gwilken/ariadne-io/public/images/ari-wind.jpeg

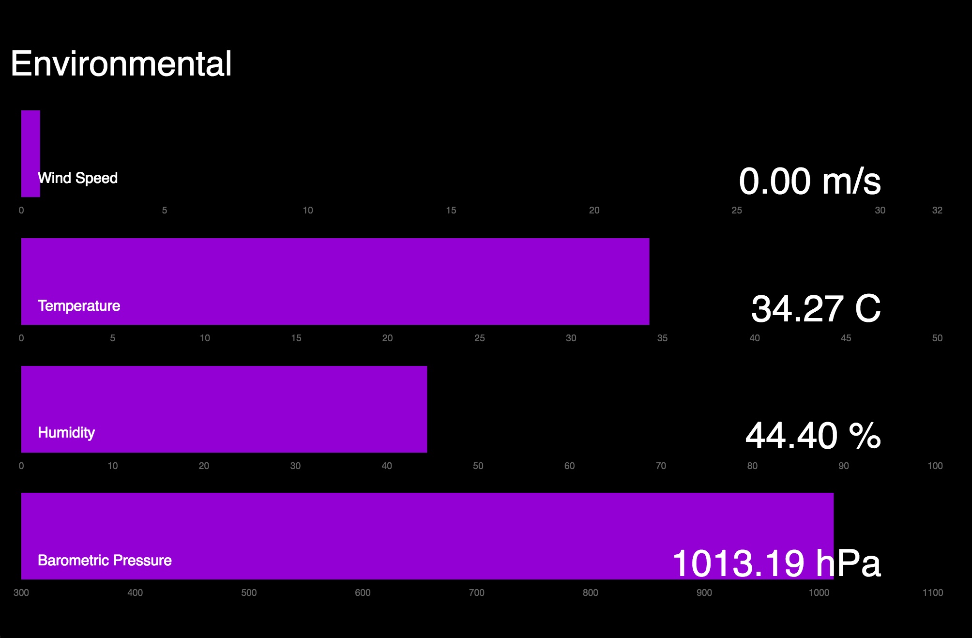
public/images/ari-wind.jpeg
