gwilken/ariadne-io/public/images/IMG_0054.jpg

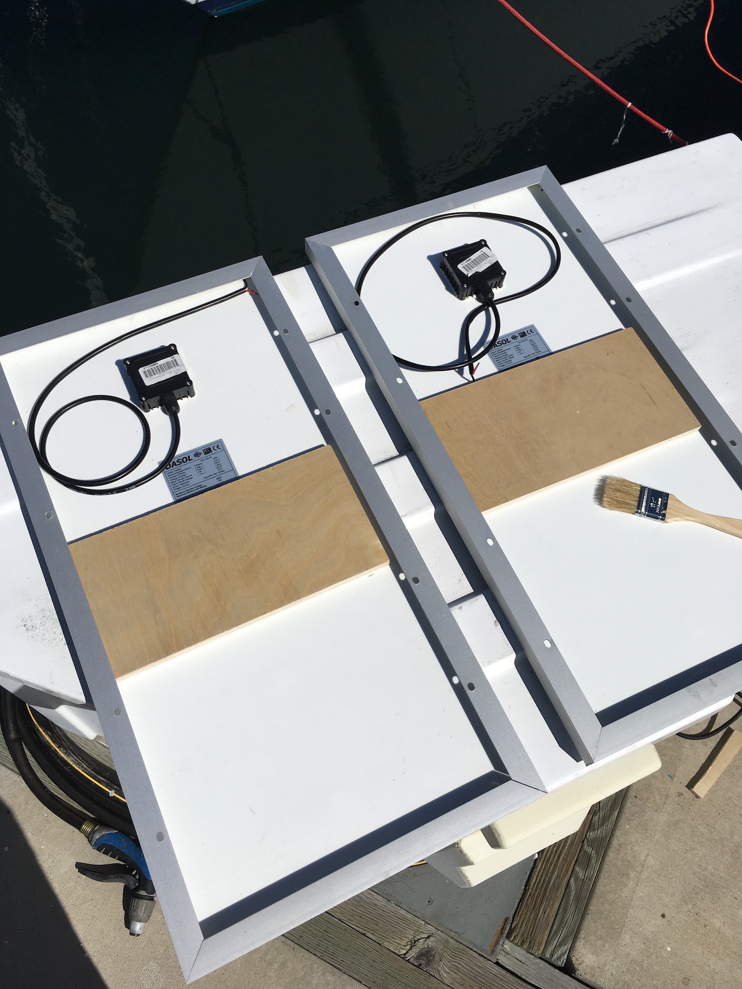
public/images/IMG_0054.jpg
