gwilken/ariadne-io/public/images/IMG_0061.jpg

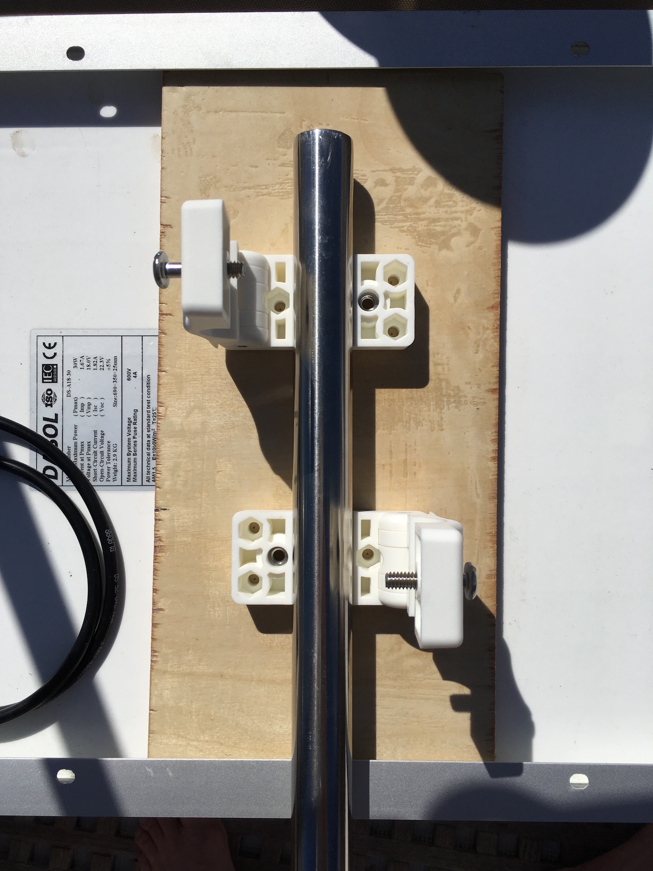
public/images/IMG_0061.jpg
