gwilken/ariadne-io/public/images/IMG_0068.jpg

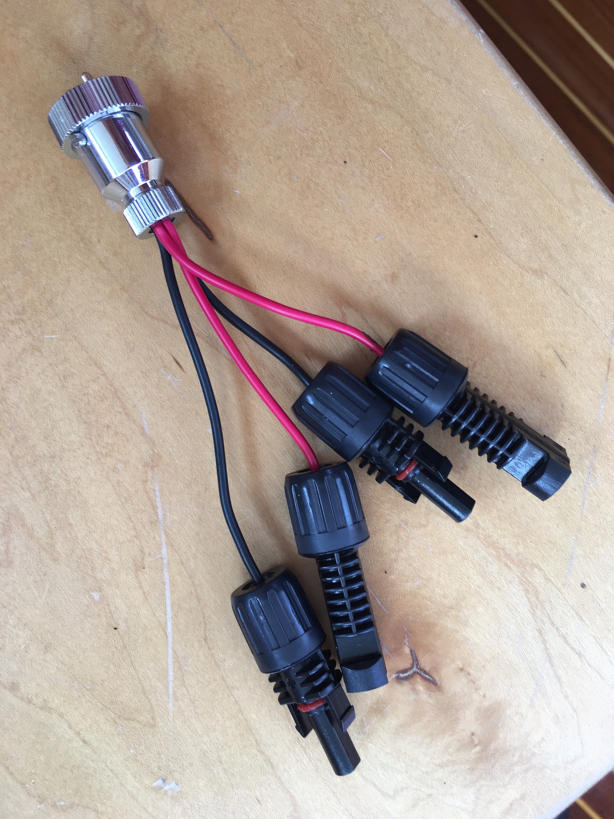
public/images/IMG_0068.jpg
