gwilken/ariadne-io/public/images/IMG_0069.jpg

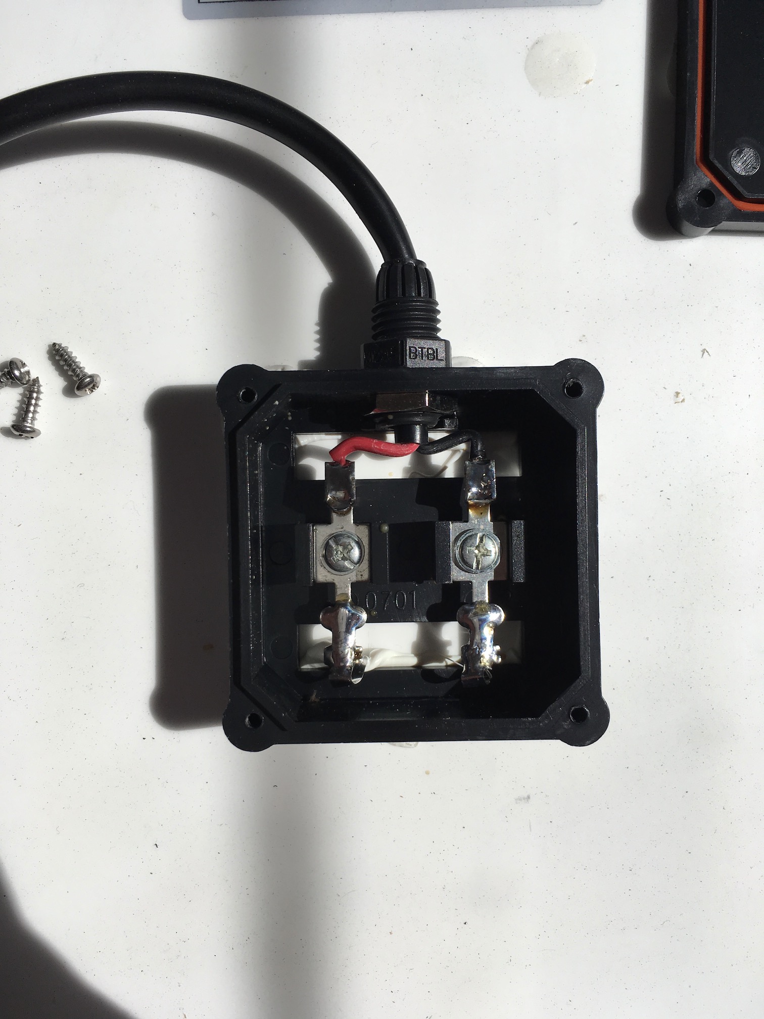
public/images/IMG_0069.jpg
