gwilken/ariadne-io/public/images/IMG_0070.jpg

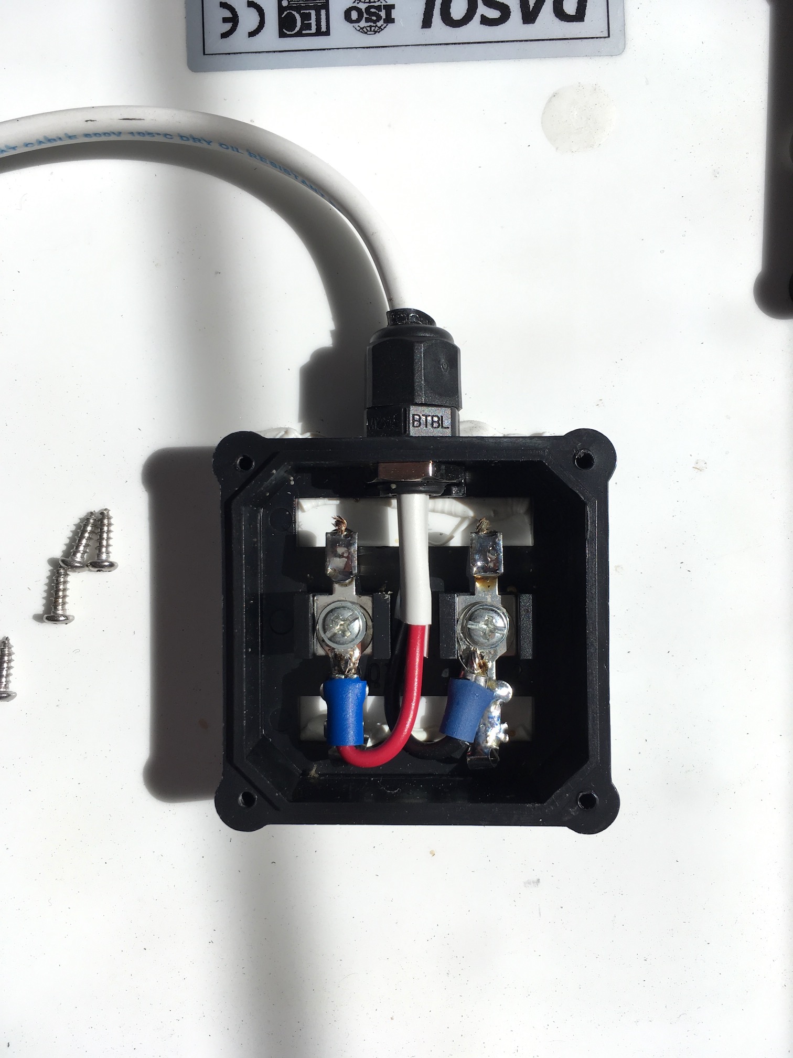
public/images/IMG_0070.jpg
