gwilken/ariadne-io/public/images/IMG_0165.jpg

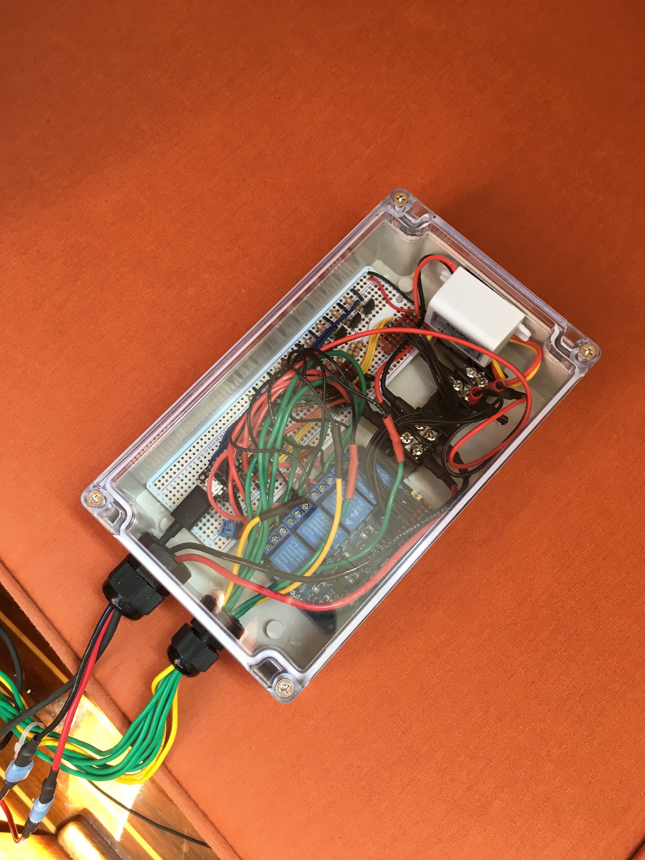
public/images/IMG_0165.jpg
