gwilken/ariadne-io/(threads)

Thread 1 (2017-08-25):

Power for the ESP's?

zmrow, 2017-08-25:
Hey there - this project is awesome!  Great work.

Curious how you're powering the ESP's?  The pictures show a red/black coming in, but I didn't see any voltage converters, etc.

gwilken, 2017-08-26:
Hey thanks! The power converters are inside the enclosures. They are just simple 12v to 3.3v down steppers. You could definitely build a better solution onto the circuit boards themselves. These were cheap, easy, and seemed overbuilt for the job.

https://www.amazon.com/gp/product/B00C64ZJYU/ref=oh_aui_detailpage_o01_s01?ie=UTF8&psc=1

zmrow, 2017-08-28:
Thanks!

Closed 2017-08-26.

Thread 2 (2017-08-28):

Pelican case

mookiejones, 2017-08-28:
Where did you get the cases from?

gwilken, 2017-08-28:
That case is a Pelican 1050:
https://www.amazon.com/Pelican-1050-Micro-Carabiner-Clear/dp/B001PYL1BM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

Probably a better way to do it, but it works. An issue I ran into was that the Pi fits pretty tight width wise, and that doesn't leave room for your typical micro usb power cord to be sticking out, so I found a right angle adaptor that works:
https://www.amazon.com/gp/product/B01C6031MA/ref=oh_aui_detailpage_o03_s00?ie=UTF8&psc=1

I drilled holes into the pelican case and added water proof wiring glands to keep everything dry, you'll need some big ones to pass the end of the USB cables through, I use these for smaller cables which should give you an idea of what you're looking for:
https://www.amazon.com/gp/product/B01GJ03AUQ/ref=oh_aui_detailpage_o02_s00?ie=UTF8&psc=1

hope that helps!

Closed 2017-08-28.

Thread 3 (2018-02-17):

Anemometer sensor and speed

beaucollins, 2018-02-17:
What kind of anemometer are you reading from?

Would this work with any mast mounted anemometer you see on a sailboat? (I’m not sure what model mine is.)

For speed are you using
