gwilken/ariadne-io/(commit log)

2017-06-19 sensor code almost there
2017-06-19 sensor code revisions
2017-06-20 code for sensors done, working
2017-06-20 motor data module working
2017-06-20 hub.js handling sensor websocket sends
2017-06-20 socket.io test
2017-06-20 working on socket listen
2017-07-14 sensor firmware updates
2017-07-14 motor module json structure change
2017-07-14 motor data json update
2017-07-14 gps and motor unit json update
2017-07-15 hub mongo insert update
2017-07-20 motor bank component change
2017-08-02 line tension change on historical graphs
2017-08-25 battery monitor sensor firmware change
2017-08-25 new family component: motor batteries
2017-08-26 motor battery group component added
2017-08-26 refrigerator temp sensor firmware added
2017-08-26 added beer sensor! (fridge temp)
2017-08-27 refactored React data flow, much faster now
2017-08-27 refactored React data flow, much faster
2017-08-27 motor batts display to hundreths
2017-08-27 enviro sensor temp firmware unit change
2017-08-27 refactor realtime bar, better data flow through components
2017-08-31 sensor battry dead bug
2017-08-31 sensor dead battery bug
2017-09-02 motor state of charge range fix
    [motor.js]
2017-12-29 updated sensor firmware
